porokka/lulzbot-taz-manta-m8p/docs/README.md

# Full conversion guide

The complete guide — wiring, host setup, firmware, commissioning order,
Meteor 175 notes, Marlin→Klipper translation and diagnostics — is maintained
as a live document and exported here.

See the repo description for the online link.
