porokka/lulzbot-taz-manta-m8p/stl/sfs_bracket.stl

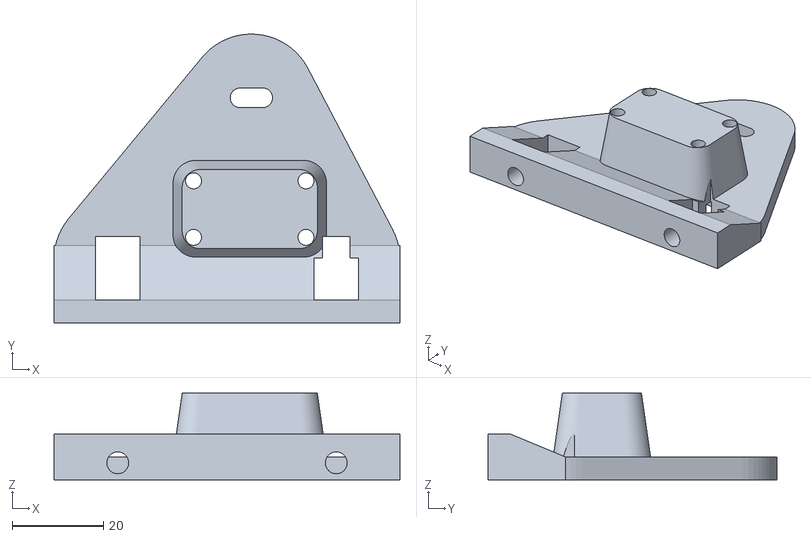
[picture p1: CAD file, 2026-10-22]
stl/sfs_bracket.stl
76.0 x 63.5 x 19.0
