porokka/lulzbot-taz-manta-m8p/config/printer.cfg

# LulzBot TAZ 5 + Meteor 175 (0.6mm) + Bondtech LGX Ace, on BIGTREETECH Manta M8P V2.0
# Generated 2026-09-30 from the machine's known-good Marlin/RAMBo values (Configuration.h,
# EEPROM M503 dump) plus BTT's official V2.0 pin map. NOT YET FLASHED/TESTED ON HARDWARE.
#
# Before first power-on of steppers:
#   1. Flash MCU firmware for this board first (see notes at bottom).
#   2. TMC2209 drivers are on order - run_current values below are set for when they
#      arrive. Until then, comment out every [tmc2209 ...] section (drivers unplugged
#      will just show as missing, safe) or Klipper will refuse to start.
#   3. Z2 (second Z motor) is now on Manta's own Motor4 socket - the RAMBo-era "E1
#      header" hack is obsolete, the cable no longer needs to stay on that workaround.
#   4. TEST EVERY AXIS DIRECTION in tiny increments before trusting this - dir_pin
#      inversions were carried over from Marlin's INVERT_*_DIR but never verified on
#      this board's wiring.

[include mainsail.cfg]
# 2026-10-16: pt1000_test.cfg DISABLED. The PT1000 moved job - it is no longer a
# bare bench sensor on TH0, it now drives the Noctua via [temperature_fan noctua]
# below, which claims PB0 itself. PB0 cannot be claimed twice.
#[include pt1000_test.cfg]

# ========================================================================
# MCU
# ========================================================================
[mcu]
# UPDATE THIS after flashing - find the real path with:
#   ls /dev/serial/by-id/*
serial: /dev/serial/by-id/usb-Klipper_stm32h723xx_0D0017000551333231343036-if00

[printer]
kinematics: cartesian
max_velocity: 300
max_accel: 3000
max_z_velocity: 5          # TAZ5 Z lead screw - keep conservative until tuned
max_z_accel: 100

# ========================================================================
# STEPPERS - bed/travel geometry from Marlin Configuration.h (TAZ5 block):
#   X_BED_SIZE 298, Y_BED_SIZE 285, X -20.1..300.1, Y 0..300, Z max 290.7
#   steps/mm from EEPROM M92: X100 Y100 Z1600 E410
#   home directions all MIN (X_HOME_DIR/Y_HOME_DIR/Z_HOME_DIR = -1)
# ========================================================================

[stepper_x]
step_pin: PE6
dir_pin: PE5
enable_pin: !PC14
microsteps: 16
rotation_distance: 32          # = 200 full_steps * 16 microsteps / 100 steps/mm (Marlin M92 X100)
endstop_pin: ^!PF4                # ^ pullup + ! invert. VERIFIED BY OBSERVATION
                                # 2026-10-16: untouched read 1 and pressing read 0,
                                # i.e. triggered = LOW, matching Marlin's
                                # ENDSTOPPULLUPS + X_MIN_ENDSTOP_INVERTING true.
                                # Without the ! an OPEN switch reads as triggered
                                # and homing stops instantly without moving.
position_endstop: -20.1        # LULZBOT_X_MIN_POS
position_min: -20.1
position_max: 300.1            # LULZBOT_X_MAX_POS
homing_speed: 50

[stepper_y]
step_pin: PE2
dir_pin: !PE1                   # INVERTED. Marlin INVERT_Y_DIR true (the
                                # 2026-09-07 Y flip). CONFIRMED 2026-10-16: without
                                # the ! a negative jog drove the bed further toward
                                # Y-max instead of toward Y0.
enable_pin: !PE4
microsteps: 16
rotation_distance: 32          # = 200 full_steps * 16 microsteps / 100 steps/mm (Marlin M92 Y100)
endstop_pin: ^!PF3                # inverted - see stepper_x
position_endstop: 0            # LULZBOT_Y_MIN_POS
position_min: 0
position_max: 300              # LULZBOT_Y_MAX_POS
homing_speed: 50

# Z1 - the motor that stayed on the original Z position (right side, X-max side
# per the 2026-09-24 G34 session). This is the axis with the physical Z endstop.
[stepper_z]
step_pin: PB8
dir_pin: PB7                   # Marlin had INVERT_Z_DIR false for TAZ5 - verify on first jog
enable_pin: !PE0
microsteps: 16
rotation_distance: 2           # = 200 full_steps * 16 microsteps / 1600 steps/mm (Marlin M92 Z1600)
endstop_pin: ^!PF2                # inverted - see stepper_x
position_endstop: 0
position_min: -4                # 2026-10-19: probe contact is at about Z0, so with
                                # position_min 0 the move ends before it triggers.
                                # -2 only: the crash at -5 put the NOZZLE through the
                                # glass, which places the glass near Z-3.5, so -2
                                # keeps ~1.5mm of margin. Do NOT go lower.
position_max: 290.7            # LULZBOT_Z_MAX_POS
homing_speed: 8
second_homing_speed: 3
homing_retract_dist: 3

# Z2 - the motor moved during the 2026-09-24 G34 conversion (left side, X-min side).
# On RAMBo this was jury-rigged onto the E1 header; on the Manta it has its own proper
# Motor4 socket - no more spare-extruder-driver workaround needed.
[stepper_z1]
step_pin: PB4
dir_pin: PB3
enable_pin: !PB6
microsteps: 16
rotation_distance: 2           # match stepper_z once that value is confirmed correct

# ========================================================================
# Z TILT - replaces Marlin's G34 (Z_STEPPER_AUTO_ALIGN). Probe points mirror the
# G34_M422 points used in Marlin: right side ~X230/Y145, left side ~X10/Y145.
# Runs automatically before each print via a start-gcode macro (add one - see bottom).
# ========================================================================
[z_tilt]
z_positions:
    0, 145                      # stepper_z  = Motor3 = LEFT screw (X-min side)
    290, 145                    # stepper_z1 = Motor4 = RIGHT screw (X-max side)
#                               # 2026-10-19: SWAPPED. Was 290 first, which sent each
#                               # correction to the wrong screw - Z_TILT_ADJUST
#                               # diverged (range 1.525 -> 3.259 instead of shrinking).
points:
    292, 127                    # probe lands (240,145) - near RIGHT screw at X290
    67, 127                     # probe lands (15,145)  - near LEFT  screw at X0
#                               # 2026-10-19: these are NOZZLE coords. Probe offset
#                               # is -52/+18, so the old (10,145) put the probe at
#                               # X-42, off the bed entirely - Z_TILT_ADJUST would
#                               # have probed thin air.
speed: 100
horizontal_move_z: 10
retries: 10
retry_tolerance: 0.01            # 2026-10-19: was 0.02. PROBE_ACCURACY shows the
                                 # probe resolves to 0.003 std dev, so this is NOT
                                 # probe noise - the residual is lead-screw backlash
                                 # and gantry settling. 0.02 is tighter than a TAZ 5
                                 # Z axis can hold, so Z_TILT bounced and hit
                                 # "Too many retries" at ~0.05.

# ========================================================================
# EXTRUDER - Bondtech LGX Ace (rebuilt 2026-09-28 after the mush jam) +
# Meteor 175 hotend, 0.6mm nozzle. Motor5 socket on the Manta.
#   rotation_distance: back-calculated from this machine's own EEPROM-calibrated
#   E410 steps/mm (M92 readback), not Bondtech's generic "~400 steps/mm" spec figure -
#   200*16/410 = 7.805. The two are close but not identical; re-verify with a real
#   100mm extrude test after flashing regardless, since the LGX was rebuilt since
#   that calibration was last measured.
#   PID: DO NOT reuse the Marlin EEPROM numbers (14.64/0.96/56.06) - Klipper's PID
#   constants use different internal scaling. Run PID_CALIBRATE HEATER=extruder
#   TARGET=205 after first successful print start and paste the result in here.
# ========================================================================
# ========================================================================
# 2026-10-16: BENCH SCAFFOLDING REMOVED. [extruder] and [heater_bed] are live
# again and [manual_stepper e_test] is gone - all looms are connected.
#
# SENSOR SWAP (2026-10-16): the PT1000 is NOT in the hotend. It stays on TH0
# reading the driver area to regulate the Noctua. The hotend keeps its stock
# 100k EPCOS thermistor, now on TH1 = PC5. Derived from the Marlin config
# running this machine: TEMP_SENSOR_0 = 1 = 100k EPCOS, same table as the bed.
# Cost of the swap: hotend ceiling is the thermistor's ~300 C, not the PT1000's
# 400 C. Irrelevant for current filaments; it defers the PEEK roadmap only.
# ========================================================================
[extruder]
step_pin: PG13
dir_pin: !PG12                  # INVERTED. Marlin INVERT_E0_DIR true for TAZ5.
enable_pin: !PG15
microsteps: 16
rotation_distance: 7.805        # 200*16/410 from this machine's own M92 E410
nozzle_diameter: 0.6
filament_diameter: 1.75
heater_pin: PA0                 # HE0
sensor_pin: PC5                 # TH1 - stock 4.7k pullup, NOT TH0's 2.2k
sensor_type: EPCOS 100K B57560G104F
control: pid
pid_Kp: 19.178                  # PID_CALIBRATE HEATER=extruder TARGET=205, 2026-10-19
pid_Ki: 0.820
pid_Kd: 112.194
min_temp: 10                    # DELIBERATE GUARD, not a typo. BTT's docs say the
                                # PT1000 jumper sets the pullup for "TH0-TH1", which
                                # may mean TH1 shares TH0's 2.2k. If it does, this
                                # 100k EPCOS reads about 5 C at a true 20 C - too
                                # COLD, which is the dangerous direction: the heater
                                # would drive straight past target. min_temp 10 turns
                                # that silent misread into a refusal to start.
                                # If Klipper won't start and reports extruder below
                                # minimum: TH1 shares the jumper. Add
                                # pullup_resistor: 2200 here, do not lower min_temp.
max_temp: 260
pressure_advance: 0.02          # MEASURED 2026-10-20 with Orca's PA pattern test
                                # (accelerations 100-1000). The bulge at the end of
                                # each line shrank towards zero, smallest around 0.02.
                                # Low is expected here: the Meteor 175 is high-flow, so
                                # its short wide melt path builds less pressure and
                                # needs less advance to compensate.
max_extrude_only_distance: 100

[heater_bed]
heater_pin: PF5
sensor_pin: PB1                 # THB
sensor_type: EPCOS 100K B57560G104F
                                # Stock TAZ 5 bed thermistor, NOT a PT1000.
                                # Marlin TEMP_SENSOR_BED 1 = 100k EPCOS, 4.7k pullup.
control: pid
pid_Kp: 57.502                  # PID_CALIBRATE HEATER=heater_bed TARGET=60, 2026-10-19
pid_Ki: 1.071                   # measured on this machine - watermark gave a
pid_Kd: 771.968                 # +-2.5 C swing (on at 48, off at 53)
min_temp: 10
max_temp: 130

# ---------------------------------------------------------------- FANS
# Port assignment VERIFIED BY OBSERVATION 2026-10-16, not inferred: each header
# was exposed as a [fan_generic] and driven one at a time while watching which
# physical fan turned. The config previously had [fan] on PF7, which was wrong -
# PF7 is the heatbreak fan. Had that shipped, the heatbreak fan would have been
# slicer-controlled and therefore OFF during the first layers while the hotend
# was hot: textbook heat creep, and the LGX Ace clog at layer 80-84 is already
# on record from exactly that failure.
#
#   PF7  Fan0  heatbreak     24 V  -> [heater_fan]   (CONFIRMED by observation)
#   PA4  Fan4  part cooling  24 V  -> [fan]          (CONFIRMED by observation)
#   PA6  Fan5  Noctua        12 V  -> [temperature_fan], tach on PC2
#
# The two voltage-jumper mistakes are NOT symmetric: 24 V into the 12 V Noctua
# kills it instantly; 12 V into a 24 V hotend fan merely halves its speed, which
# looks fine and silently causes heat creep weeks later.
# -----------------------------------------------------------------------
[heater_fan hotend_fan]
pin: PF7
heater: extruder
heater_temp: 50.0
fan_speed: 1.0                  # 2-WIRE 5 V fan (black+red only). Speed is set by
                                # the supply, so PWM here is the correct method.
                                # Kept at 1.0 because a heatbreak fan should run flat
                                # out whenever the hotend is hot - but unlike a 4-wire
                                # fan, lowering it is technically safe.
                                # No tach wire, so no RPM monitoring is possible.

[fan]
pin: PA4

[temperature_fan noctua]
pin: PA6
tachometer_pin: PC2
sensor_type: PT1000
sensor_pin: PB0                 # TH0
pullup_resistor: 2200           # VERIFIED 2026-10-14: the M8P PT1000 jumper makes
                                # this divider 2.2k. With Klipper's 4700 default
                                # this exact sensor read 360.87 C at a true 24 C.
                                # A wrong pullup returns a PLAUSIBLE number, never
                                # an error.
control: watermark
max_delta: 2
target_temp: 45
min_temp: 0
max_temp: 100
off_below: 0.2                  # a Noctua stalls and buzzes at very low duty
                                # rather than spinning - stop it cleanly instead

[bltouch]
sensor_pin: ^PD13                # ^ = pullup. Clones sometimes need ^! instead;
                                # QUERY_PROBE reporting TRIGGERED while the pin is
                                # retracted and clear means add the !
control_pin: PD12
pin_up_reports_not_triggered: False
pin_up_touch_mode_reports_triggered: False
probe_with_touch_mode: False            # 2026-10-19: set False per 3DTouch clone guidance.
                                # Klipper docs: many clones do NOT support touch
                                # mode. Evidence here: holding the pin raised an
                                # alarm, which in real touch mode would not happen.
stow_on_each_sample: True
#                               # 2026-10-19: touch mode added. In NORMAL mode a
#                               # clone emits only a BRIEF PULSE on trigger, which
#                               # is why QUERY_PROBE polling never caught it and
#                               # why PROBE ran the full travel into the bed. In
#                               # TOUCH mode the signal is HELD while the pin is
#                               # pushed. Documented clone fix - klipper3d.org/BLTouch
#                               # 2026-10-19: this is a 3D TOUCH (clone), not a
#                               # genuine Antclabs BLTouch. Clones do not support
#                               # Klipper's sensor-state verification tests, which
#                               # is what produced "BLTouch failed to verify sensor
#                               # state" on every PROBE. These two lines disable
#                               # those checks. Required for 3D Touch / clones.
x_offset: -52
y_offset: 18
# MEASURED 2026-10-14 against the OctoGrabs grid squares. Was -45/15, which is
# wrong by 7mm in X and 3mm in Y - that error put every G29 reading 7mm from
# where it was actually taken and caused weeks of left-low/right-high first
# layers on the Marlin side before it was found.
# When the BTT Eddy replaces the BLTouch on the same bracket, RE-MEASURE: its
# sensing point is the centre of the coil, not a pin tip.
#z_offset: 0                     # run PROBE_CALIBRATE to set this - do not guess from Marlin's -3.485

[safe_z_home]
home_xy_position: 30.1, 259.5   # matches Marlin's Z_SAFE_HOMING point
speed: 100
z_hop: 15
z_hop_speed: 5

[bed_mesh]
speed: 120
horizontal_move_z: 10
mesh_min: 10, 20
mesh_max: 245, 275
# Recomputed for the -52/+18 offset. The nozzle sits at (mesh - offset), so
# with X travel capped at 300.1 the probe cannot pass X248.1 - the previous
# mesh_max of 280 needed the nozzle at 332 and BED_MESH_CALIBRATE would simply
# have failed. Y is limited the other way: reaching mesh_y 18 needs the nozzle
# at Y0, so 20 is the practical front edge.
# Net effect vs the old values: a LOT more bed. 55->10 on the left recovers
# 45mm that was being extrapolated rather than measured.
# NOTE for the Eddy: horizontal_move_z below must drop from 10 to about 2 -
# eddy sensing range is only a few mm and it reads nothing at 10.
probe_count: 15, 15
algorithm: bicubic

# ========================================================================
# TMC2209 - drivers on order as of 2026-09-30. Leave this whole block commented
# until they're physically installed, or Klipper will fail to start looking for
# UART devices that aren't there yet.
#   E0 current set to 0.55A per Bondtech's LGX Ace Pro guidance (500-600mA range),
#   NOT the Manta template's default 0.8A - that's sized for a full NEMA17, not
#   the LGX's pancake motor, and running it hot was the likely cause of the
#   2026-09-30 silent-stall failure on the RAMBo.
# ========================================================================
[tmc2209 stepper_x]
uart_pin: PC13
run_current: 0.8
stealthchop_threshold: 999999

[tmc2209 stepper_y]
uart_pin: PE3
run_current: 0.8
stealthchop_threshold: 999999

[tmc2209 stepper_z]
uart_pin: PB9
run_current: 0.8                 # 2026-10-19: was 0.65. The two Z motors were going
                                # OUT OF SYNC, i.e. one losing steps under the
                                # gantry load. 0.65 A is low for lifting a gantry,
                                # and StealthChop is weaker than SpreadCycle.
stealthchop_threshold: 999999

[tmc2209 stepper_z1]
uart_pin: PB5
run_current: 0.8                 # 2026-10-19: was 0.65. The two Z motors were going
                                # OUT OF SYNC, i.e. one losing steps under the
                                # gantry load. 0.65 A is low for lifting a gantry,
                                # and StealthChop is weaker than SpreadCycle.
stealthchop_threshold: 999999    # 2026-10-19: back to StealthChop to MATCH stepper_z.
                                # Was 0 (SpreadCycle) only as an open-load
                                # diagnostic. Mixed modes on a dual-Z give the two
                                # motors different torque characteristics.

[tmc2209 extruder]
uart_pin: PG14
run_current: 0.55               # LGX Ace Pro pancake motor - NOT the template's
                                # 0.8 A, which is sized for a full NEMA17 and was
                                # the likely cause of the 2026-09-30 silent stall
stealthchop_threshold: 999999

# ========================================================================
# START/END GCODE MACROS - mirrors the Marlin start gcode logic from this session:
# heat, soak, home, Z_TILT_ADJUST (replaces G34), load bed mesh, purge line.
# ========================================================================
# ======================================================================
# BTT Smart Filament Sensor V2.0
#
# Headers are silkscreened M1-STOP..M6-STOP, numbered FROM ONE:
#   M1 PF4   M2 PF3   M3 PF2   M4 PF1   M5 PF0   M6 PC15
# Pin order on each is  SIG / G / +5V.
#
#   M4 PF1 : blue SWITCH on SIG(1), red VCC on +5V(3)  - skips the ground pin
#   M5 PF0 : green MOTION on SIG(1), black GND on G(2) - adjacent
#
# HARD-WON: the encoder was silent for hours and looked like dead silicon.
# It was the MOUNTING SCREWS - M3x20 reached 5 mm into the housing and jammed
# the encoder wheel. The switch half kept working throughout, which is what
# made it look electrical. Use M3x16. See stl/sfs_bracket.scad.
#
# Also: a filament_motion_sensor reports filament_detected True permanently
# unless a runout is declared, so it CANNOT be used to see whether the encoder
# is pulsing. To test a motion pin, configure it as a filament_switch_sensor
# temporarily - that form tracks the raw level.
# ======================================================================

[filament_switch_sensor switch_sensor]
switch_pin: ^PF1
pause_on_runout: False
runout_gcode:
    PAUSE
    M117 Filament runout - switch
insert_gcode:
    M117 Filament inserted

[filament_motion_sensor encoder_sensor]
switch_pin: ^PF0
# BTT quote 2.88 mm, which is the sensor resolution - a single missed pulse
# would then pause a print. 7 mm gives margin while still catching a jam in
# well under a layer. Tighten later if false triggers never appear.
detection_length: 7
extruder: extruder
pause_on_runout: False
runout_gcode:
    PAUSE
    M117 Filament jam - no motion detected
insert_gcode:
    M117 Filament motion resumed

[gcode_macro START_PRINT]
# Order matters more than any single step. The bed, frame and Z screws all grow
# as they heat, so homing and levelling before the bed is hot sets a Z reference
# that has moved by the time the first layer goes down. Measured on this machine:
# the bed is 0.137 mm flatter hot than cold, and its centre sits 0.10 mm lower -
# which on a 0.25 mm first layer is enormous. Heat, soak, THEN home, level, mesh.
gcode:
    {% set BED_TEMP = params.BED|default(60)|float %}
    {% set EXTRUDER_TEMP = params.EXTRUDER|default(205)|float %}
    {% set MESH = params.MESH|default("mesh60") %}
    {% set SOAK = params.SOAK|default(480)|int %}
    {% set RETRACT = params.RETRACT|default(8)|float %}
    {% set SOAK_HOT = params.SOAK_HOT|default(60)|int %}

    # Klipper renders a macro completely before executing any of it, so this is
    # the bed temperature at the moment the print STARTED - exactly the "has it
    # already soaked?" test. Cold plate gets the full soak; a back-to-back print
    # off an already-hot one only needs a moment to settle.
    {% set BED_NOW = printer.heater_bed.temperature|float %}
    {% set soak_s = SOAK_HOT if BED_NOW >= (BED_TEMP - 5) else SOAK %}

    # Armed sensors and a purge line do not mix: the purge extrudes
    # with no print underway and can trip a runout before layer one.
    SET_FILAMENT_SENSOR SENSOR=switch_sensor ENABLE=0
    SET_FILAMENT_SENSOR SENSOR=encoder_sensor ENABLE=0

    M140 S{BED_TEMP}
    M190 S{BED_TEMP}                 ; bed to temperature first
    M109 S{EXTRUDER_TEMP}            ; full heat briefly, so the retract below
                                     ; happens while the plastic is actually
                                     ; molten - pulling back at 150 drags a
                                     ; half-set plug into the heatbreak
    G92 E0
    G1 E-{RETRACT} F1800             ; nothing to drool during probing
    G92 E0

    M104 S150                        ; drop to probing temp and soak. M190 says
    { action_respond_info("START_PRINT: bed was %.1fC - soaking %ds" % (BED_NOW, soak_s)) }
    G4 P{soak_s * 1000}              ; "target" long before an Octograb stack is
                                     ; uniform at the surface the plastic touches

    G28                              ; home HOT
    Z_TILT_ADJUST                    ; level HOT
    BED_MESH_PROFILE LOAD={MESH}

    ; A missing mesh looks exactly like a bad first layer and costs just as much.
    ; This lives in its own macro ON PURPOSE. Klipper renders a macro fully
    ; before executing any of it, so an inline check here would read bed_mesh
    ; state from BEFORE the load above ran - and would abort every cold start.
    ; A called macro renders at the moment it is reached, so it sees the truth.
    _CHECK_MESH EXPECT={MESH}

    M109 S{EXTRUDER_TEMP}            ; back to printing temperature
    G90
    G1 Z2 F600
    G1 X40 Y85 F3000
    G1 Z0.4 F300
    G92 E0
    G1 X90 Y85 E{RETRACT + 4} F300   ; re-prime the retract AND the usual prime,
    G92 E0                           ; or the first layer starts starved

    # Print proper starts here - arm the switch. The encoder stays off
    # until its hardware fault is fixed.
    SET_FILAMENT_SENSOR SENSOR=switch_sensor ENABLE=1
    SET_FILAMENT_SENSOR SENSOR=encoder_sensor ENABLE=1

[gcode_macro _CHECK_MESH]
description: Abort if no bed mesh is active. Must be CALLED, not inlined - see START_PRINT.
gcode:
    {% set want = params.EXPECT|default("") %}
    {% if printer.bed_mesh.profile_name == "" %}
        { action_raise_error("No bed mesh loaded (wanted %s) - aborting" % want) }
    {% else %}
        { action_respond_info("Bed mesh active: %s" % printer.bed_mesh.profile_name) }
    {% endif %}

[gcode_macro END_PRINT]
gcode:
    M400
    M104 S0
    M140 S0
    M107
    G91
    G1 E-2 F1800
    G1 Z10 F600
    G90
    G1 X0 Y250 F3000
    M84

# ========================================================================
# FIRMWARE FLASHING NOTES (not yet done as of 2026-09-30):
#   make menuconfig -> select "STMicroelectronics STM32", "STM32H723",
#   "128KiB bootloader", "25 MHz crystal", communication interface: Serial (on
#   USART1 PA10/PA9) unless using CAN or USB instead (board supports all three
#   per BTT's own file header - pick to match how it's actually wired).
#   Then: make clean && make
#   Flash via the DFU/BOOT0 procedure in BTT's manual, or via Katapult if
#   already using it on a v1.x board's bootloader convention.
# ========================================================================


# ========================================================================
# FORCE_MOVE - added 2026-10-16 for first-power direction testing. Lets a
# single stepper be jogged before homing, IGNORING endstops and soft limits.
# Keep distances small and watch the axis.
#   FORCE_MOVE STEPPER=stepper_x DISTANCE=-10 VELOCITY=10
# NEGATIVE = toward min. The head is parked at X-max/Y-max, so negative is the
# direction with room; a positive jog would drive it further into the end stop.
# Safe to leave enabled, but it is a footgun - it obeys no limits at all.
# ========================================================================
[force_move]
enable_force_move: True

# ===== TEMPORARY 2026-10-16 - MOTOR PORT SWEEP ========================
# Motor6 declared as a manual_stepper purely so every port can be jogged
# while watching which physical axis responds. REMOVE when done.
[manual_stepper m6_test]
step_pin: PG9
dir_pin: PD7
enable_pin: !PG11
microsteps: 16
rotation_distance: 2

[tmc2209 manual_stepper m6_test]
uart_pin: PG10
run_current: 0.5
stealthchop_threshold: 999999
# ======================================================================



# ===== TEMPORARY 2026-10-19 - locate the extruder motor ================
[manual_stepper m7_test]
step_pin: PD4
dir_pin: PD3
enable_pin: !PD6
microsteps: 16
rotation_distance: 8

[manual_stepper m8_test]
step_pin: PC7
dir_pin: PC8
enable_pin: !PD2
microsteps: 16
rotation_distance: 8
# ======================================================================

[tmc2209 manual_stepper m7_test]
uart_pin: PD5
run_current: 0.5
stealthchop_threshold: 999999

[tmc2209 manual_stepper m8_test]
uart_pin: PC6
run_current: 0.5
stealthchop_threshold: 999999

# ===== Marlin compatibility macros (2026-10-19) =======================
# The Marlin-era test gcode files use commands Klipper does not implement.
# Klipper ABORTS on an unknown command, so without these a file dies a few
# lines in - after heating and soaking.
[gcode_macro G34]
gcode:
    Z_TILT_ADJUST

[gcode_macro M420]
description: Marlin mesh enable/disable -> Klipper bed_mesh
gcode:
    {% if params.S is defined and params.S|int == 1 %}
        BED_MESH_PROFILE LOAD=default
    {% else %}
        BED_MESH_CLEAR
    {% endif %}

[gcode_macro M900]
description: Marlin linear advance -> Klipper pressure advance
gcode:
    {% if params.K is defined %}
        SET_PRESSURE_ADVANCE ADVANCE={params.K|float}
    {% endif %}
# ======================================================================

#*# <---------------------- SAVE_CONFIG ---------------------->
#*# DO NOT EDIT THIS BLOCK OR BELOW. The contents are auto-generated.
#*#
#*# [bltouch]
#*# z_offset = 1.730
#*#
#*# [bed_mesh default]
#*# version = 1
#*# points =
#*# 	-0.102361, 0.034514, 0.152639, 0.228889, 0.269514, 0.325139, 0.361389, 0.358889, 0.336389, 0.335764, 0.277639, 0.196389, 0.147014, 0.018264, -0.104861
#*# 	-0.156736, -0.019861, 0.116389, 0.225764, 0.293889, 0.345139, 0.391389, 0.403889, 0.387639, 0.366389, 0.367639, 0.296389, 0.259514, 0.123264, -0.081736
#*# 	-0.086111, 0.036389, 0.181389, 0.286389, 0.355764, 0.412639, 0.453889, 0.443889, 0.411389, 0.393889, 0.385764, 0.334514, 0.285139, 0.145764, -0.032361
#*# 	-0.079236, 0.045139, 0.195764, 0.317014, 0.392639, 0.438889, 0.463889, 0.435764, 0.392014, 0.392014, 0.411389, 0.378889, 0.335764, 0.180764, -0.004861
#*# 	-0.057361, 0.063264, 0.219514, 0.347014, 0.428264, 0.483889, 0.511389, 0.492639, 0.415764, 0.403264, 0.425764, 0.388889, 0.336389, 0.181389, 0.030764
#*# 	-0.067986, 0.060764, 0.221389, 0.358889, 0.432014, 0.502639, 0.543264, 0.544514, 0.508889, 0.467639, 0.470764, 0.421389, 0.377014, 0.232014, 0.022014
#*# 	-0.071111, 0.070139, 0.230764, 0.349514, 0.441389, 0.515139, 0.542014, 0.528264, 0.527014, 0.502014, 0.492639, 0.447639, 0.366389, 0.221389, 0.034514
#*# 	-0.060486, 0.062639, 0.222014, 0.343889, 0.447014, 0.525764, 0.551389, 0.548889, 0.565764, 0.567014, 0.578889, 0.465139, 0.394514, 0.267014, 0.055764
#*# 	-0.078611, 0.050764, 0.215764, 0.349514, 0.450139, 0.525139, 0.575764, 0.572639, 0.567639, 0.575764, 0.540764, 0.406389, 0.330139, 0.222014, 0.048264
#*# 	-0.073611, 0.055764, 0.228264, 0.361389, 0.451389, 0.520139, 0.587639, 0.597639, 0.599514, 0.575764, 0.522639, 0.415139, 0.374514, 0.268264, 0.053264
#*# 	-0.091111, 0.055764, 0.227639, 0.338264, 0.415764, 0.475139, 0.518264, 0.524514, 0.514514, 0.474514, 0.420139, 0.399514, 0.368264, 0.250139, 0.057639
#*# 	-0.111736, 0.039514, 0.197014, 0.292014, 0.362014, 0.418889, 0.459514, 0.460764, 0.444514, 0.418889, 0.407014, 0.400139, 0.387639, 0.295139, 0.064514
#*# 	-0.133611, 0.019514, 0.165764, 0.253264, 0.320764, 0.380764, 0.428264, 0.425139, 0.400139, 0.353264, 0.351389, 0.333889, 0.287639, 0.153889, -0.021736
#*# 	-0.167361, -0.001111, 0.137014, 0.220139, 0.274514, 0.336389, 0.383889, 0.408264, 0.410139, 0.383889, 0.355764, 0.306389, 0.273264, 0.140764, -0.072361
#*# 	-0.211111, -0.044861, 0.093889, 0.184514, 0.237639, 0.285764, 0.335139, 0.366389, 0.363264, 0.335139, 0.315764, 0.253264, 0.198889, 0.058889, -0.120486
#*# x_count = 15
#*# y_count = 15
#*# mesh_x_pps = 2
#*# mesh_y_pps = 2
#*# algo = bicubic
#*# tension = 0.2
#*# min_x = 10.0
#*# max_x = 244.92000000000002
#*# min_y = 20.0
#*# max_y = 274.94000000000005
#*#
#*# [bed_mesh mesh60]
#*# version = 1
#*# points =
#*# 	  -0.128500, -0.014750, 0.065250, 0.156500, 0.189000, 0.221500, 0.252750, 0.236500, 0.206500, 0.179625, 0.134000, 0.025875, -0.056625, -0.144125, -0.156000
#*# 	  -0.156000, -0.041000, 0.064000, 0.157750, 0.200875, 0.255875, 0.288375, 0.294625, 0.282125, 0.230250, 0.214625, 0.144625, 0.060875, -0.019750, -0.120375
#*# 	  -0.094750, 0.001500, 0.099625, 0.197750, 0.275875, 0.363375, 0.343375, 0.350875, 0.310250, 0.260250, 0.233375, 0.177125, 0.087750, -0.009750, -0.112875
#*# 	  -0.053500, 0.016500, 0.135250, 0.243375, 0.316500, 0.354000, 0.374000, 0.359625, 0.297125, 0.248375, 0.240875, 0.225250, 0.136500, 0.022125, -0.109125
#*# 	  -0.032250, 0.052125, 0.166500, 0.288375, 0.367750, 0.415250, 0.439000, 0.420875, 0.345250, 0.281500, 0.267125, 0.242750, 0.156500, 0.025875, -0.056625
#*# 	  -0.039750, 0.047125, 0.167125, 0.283375, 0.363375, 0.414000, 0.444625, 0.479625, 0.400875, 0.350250, 0.317750, 0.276500, 0.190875, 0.078375, -0.049750
#*# 	  -0.036625, 0.050250, 0.173375, 0.298375, 0.372750, 0.427125, 0.454625, 0.445875, 0.407125, 0.393375, 0.345875, 0.301500, 0.197125, 0.069625, -0.034750
#*# 	  -0.012875, 0.064000, 0.184000, 0.300875, 0.377750, 0.432750, 0.467750, 0.448375, 0.444000, 0.427750, 0.426500, 0.345875, 0.209625, 0.107750, -0.003500
#*# 	  -0.021000, 0.060875, 0.177125, 0.305875, 0.388375, 0.448375, 0.488375, 0.492750, 0.449625, 0.453375, 0.427125, 0.302750, 0.161500, 0.066500, -0.013500
#*# 	  0.005875, 0.079000, 0.212125, 0.331500, 0.410875, 0.458375, 0.504625, 0.518375, 0.501500, 0.469000, 0.417750, 0.290250, 0.191500, 0.112125, 0.003375
#*# 	  -0.004125, 0.076500, 0.208375, 0.324000, 0.382750, 0.420875, 0.451500, 0.459625, 0.431500, 0.392750, 0.317125, 0.246500, 0.196500, 0.117125, 0.025250
#*# 	  -0.027875, 0.061500, 0.197750, 0.287125, 0.340250, 0.385250, 0.404625, 0.400250, 0.380875, 0.329000, 0.294000, 0.249000, 0.220875, 0.145250, 0.010875
#*# 	  -0.051000, 0.051500, 0.161500, 0.253375, 0.309000, 0.340875, 0.367750, 0.375875, 0.347125, 0.280250, 0.241500, 0.212750, 0.150875, 0.065250, -0.046000
#*# 	  -0.064750, 0.026500, 0.158375, 0.236500, 0.280875, 0.303375, 0.332125, 0.355875, 0.333375, 0.310875, 0.268375, 0.205250, 0.137125, 0.032750, -0.080375
#*# 	  -0.131000, -0.017875, 0.114625, 0.200875, 0.249000, 0.262750, 0.282750, 0.319000, 0.305875, 0.270875, 0.219625, 0.159625, 0.073375, -0.036625, -0.117875
#*# x_count = 15
#*# y_count = 15
#*# mesh_x_pps = 2
#*# mesh_y_pps = 2
#*# algo = bicubic
#*# tension = 0.2
#*# min_x = 10.0
#*# max_x = 244.92000000000002
#*# min_y = 20.0
#*# max_y = 274.94000000000005
