porokka/lulzbot-taz-manta-m8p/(commit log)

2026-10-20 TAZ + Manta M8P V2.0: working Klipper config and conversion guide
    Commissioned config for a LulzBot TAZ 5 (universal toolhead adapter, also
    fits TAZ 6) with a BigTreeTech Manta M8P V2.0 and a CM4 host.
    Klipper ships no generic config for the M8P V2.0 - only v1.0/v1.1, which are
    a different MCU with a different pin map - so this fills a gap.
    Includes the V2.0 pin map, TAZ-specific geometry and endstop polarity,
    dual-Z notes, and the traps that cost the most time during commissioning.
    [mainsail.cfg, printer.cfg]
2026-10-20 Calibrated: z_offset 1.730, extruder verified, first successful print
    - rotation_distance 7.805 CONFIRMED by 100mm extrude test (delivers exactly
    100mm), so the Marlin M92 E410 conversion was correct after all
    - z_offset measured and saved: 1.730
    - pressure_advance 0.03 set as a starting estimate, NOT yet measured
    - flow back to 100% (old test files carried M221 S155 from the RAMBo era)
    First layer now lays continuous merged lines. Remaining artefacts at line
    ends point to pressure advance, which still needs a proper tower test.
    [printer.cfg]
2026-10-20 pressure_advance 0.02, measured
    Orca PA pattern test (accelerations 100-1000). The bulge at the end of each
    line shrank towards zero, smallest around 0.02.
    A low value is expected rather than suspicious: the Meteor 175 is a high-flow
    hotend, so its short wide melt path builds less pressure and needs less
    advance to compensate.
    Every setting on this machine is now a measurement rather than an estimate -
    rotation_distance by ruler, z_offset by probe calibration, PID by
    PID_CALIBRATE, mesh by 225 probed points, PA by this test.
    [printer.cfg]
2026-10-21 Add SFS V2.0 bracket for the TAZ universal toolhead adapter
    Mounts a BTT Smart Filament Sensor to the adapter's three existing
    fixings. Those sit on perpendicular screw axes - shelf screws vertical,
    nose slot horizontal - so the part needs an L-foot rather than being a
    flat plate.
    All dimensions measured from the adapter STL. Two traps in that file are
    documented in stl/README.md: its stored facet normals are wrong, and it
    contains four coincident-face seams 50nm deep that read as real holes.
    Geometry corrected twice against the fitted part.
    [sfs_bracket.scad, sfs_bracket.stl]
2026-10-21 SFS bracket: lever clearance verified on the fitted part, no cut needed
    The sensor body is wider than the LGX Ace, so it clears the tension
    lever without any relief and the lever stays reachable.
    [sfs_bracket.scad]
2026-10-22 Fix first layer: level hot, not cold. Plus filament sensor and bed study
    START_PRINT was homing and levelling before the bed was hot, then heating.
    Everything grows during the soak, so the Z reference it established had
    moved by the time the first layer went down. Measured on this machine: the
    bed is 0.137 mm flatter hot than cold and its centre sits 0.10 mm lower,
    which on a 0.25 mm first layer is most of the layer. Reordered to heat,
    soak, then home, level and load the mesh.
    - conditional soak: full 8 min from cold, 60 s if the bed is already hot
    - 8 mm retract before probing, taken while the plastic is still molten;
    purge raised to compensate so the first layer does not start starved
    -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
    [printer.cfg]
2026-10-22 SFS bracket: M3x16, not x20 - longer screws jam the encoder wheel
    I specified M3x20 for 5 mm of engagement into the sensor. That 5 mm reaches
    the encoder wheel and stops it turning. The switch half carries on working,
    so from the board it presents as dead encoder electronics - silent on every
    pin tested, no LED response to filament movement.
    Found mechanically: the wheel turned freely with the housing open and bound
    as soon as it was closed.
    [sfs_bracket.scad, sfs_bracket.stl]
2026-10-22 Filament sensor working: both halves armed
    The encoder was never faulty. M3x20 mounting screws reached 5 mm into the
    sensor housing and jammed the encoder wheel; the switch half kept working,
    so it presented as dead electronics. M3x16 freed it and the motion line
    pulses correctly.
    - switch_sensor ^PF1 (M4-STOP, blue+red) runout -> PAUSE
    - encoder_sensor ^PF0 (M5-STOP, green+black) jam -> PAUSE
    - detection_length 7, not BTT's 2.88: that figure is the raw sensor
    resolution, so a single missed pulse would pause a print
    - START_PRINT disables both before homing and the purge, re-enables after
    Recorded in the config: a filament_motion_sensor reports filament_detected
    True permanently unl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
    [printer.cfg]
2026-10-22 Bed study: the plate does not reseat repeatably
    Re-probed mesh60 under identical conditions after the plate was taken off,
    rotated for the orientation test and put back. Range went 0.674 -> 0.978,
    which is larger than the plate's entire published tolerance band.
    The change is a pure front-to-back tilt of ~0.39 mm - X10 and X245 read the
    same at mid-bed, so zero X tilt. Both Z motors sit at y=145, so Z_TILT_ADJUST
    cannot touch it; only the mesh compensates.
    Optimum correction is 0.40 mm lift on both back corners, giving 0.787. It
    cannot reach the previous 0.674 because the X bow worsened too, 0.48 to 0.65.
    Also raised z_offset 1.730 -> 1.780; the first layer had been under-squished
    two day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
